ve-dima/FlightController_v2.0/doc/RC/RC.md

# Настройка пульта

Данный раздел описывает минимально необходимые действия, которые необходимы для подключения пульта к *Fly MCU 2.0*.

**ВЫПОЛНЯТЬ С СТРОГО ОТКЛЮЧЕННЫМИ ESC ОТ ПЛАТЫ ИЛИ СО СНЯТЫМИ ВИНТАМИ**

## Шаг 0. Подключение приёмника

Установите приёмник на любое удобное место в БПЛА. Закрепите также и антенны так, что бы они не попали в винты.

Затем возьмите 3 провода мама-мама и подключите их в разъём ***iBus servos*** (верхний правый угол).

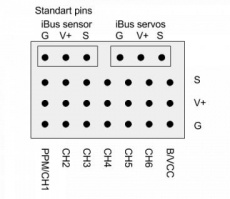
[picture p5: doc/RC/pinout.png]


Подключение к *Fly MCU 2.0* выполняется по следующей схеме:
| FS-iA6B, *iBus servos* | Fly MCU 2.0, *RC UART*, на плате LPUART1 |
| --- | --- |
| G | GND |
| V+ | +5V |
| S | RX |

Если, как минимум, **GND** и **+5V** были подключены правильно, при подключении питания загорится индикатор на приёмнике, сигнализирующий о наличии питания.

## Шаг 1. Привязка приёмника к передатчику

Затем необходимо обесточить БПЛА. Воткните bind-кабель (при отсутствии можно обычным кабелем мама-мама) в крайний правый разъём **B/VCC** приёмника.

(!) Предыдущее подключение остаётся на месте, шаги 2 и 4 с изображения не актуальны.

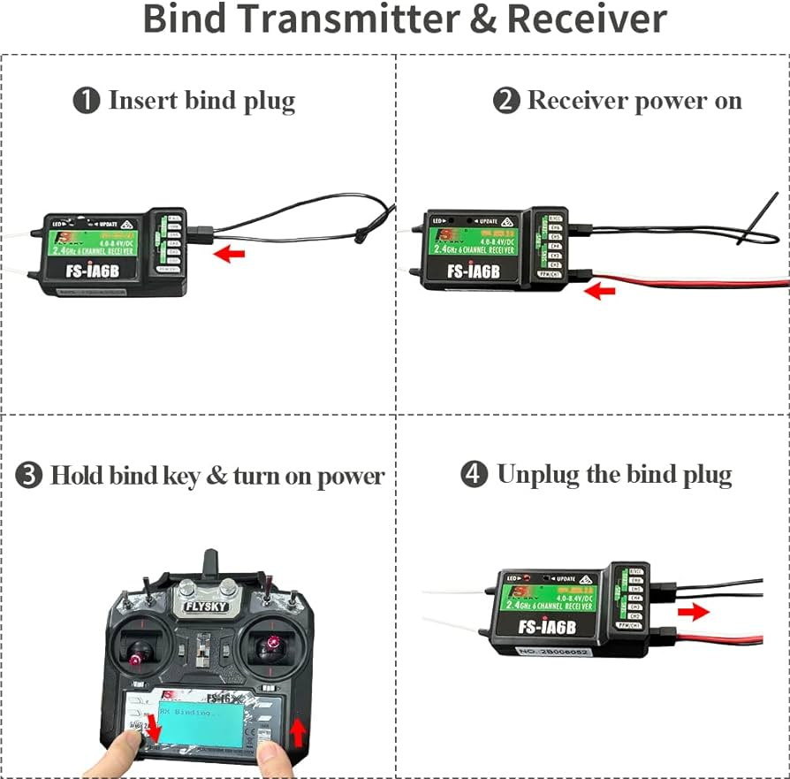
[picture p6: doc/RC/bind.jpg]


Убедитесь, что отключен и БПЛА, и пульт. Затем зажав **bind-key** включите передатчик. Вы должны увидеть надпись *RX Binding...*.

Затем включите БПЛА. Если все шаги были выполнены успешно, вы увидите экран с качеством сигнала и напряжением.

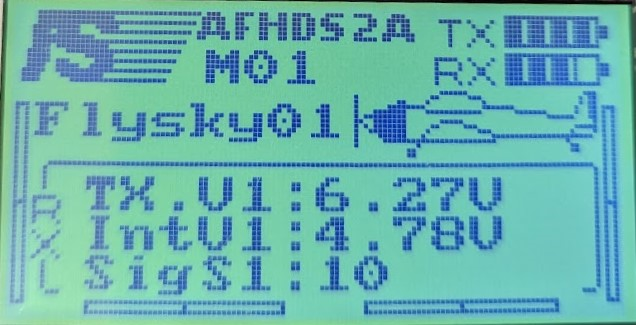
[picture p7: doc/RC/hello.jpg]


## Шаг 2. Настройка выхода

Удержанием кнопки **OK** (правее дисплея) зайдите в системное меню и кнопками **UP/DOWN** (левее дисплея) выберете пункт **System setup**.

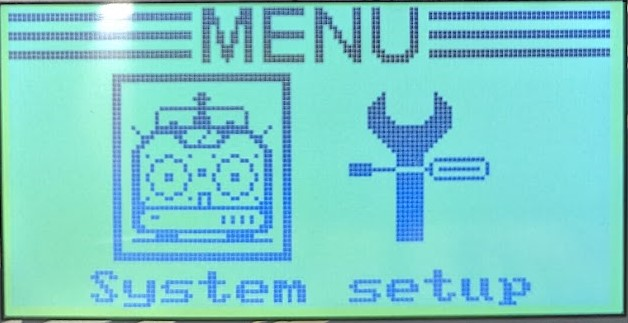
[picture p8: doc/RC/menu.jpg]


Найдите пункт **RX Setup**...

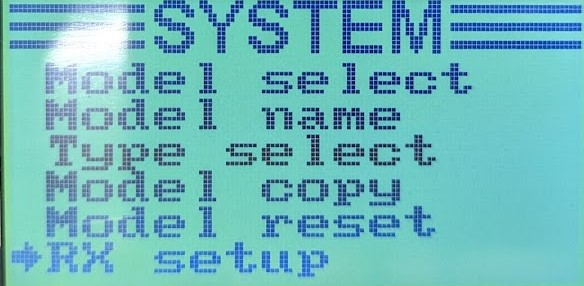
[picture p9: doc/RC/rx setup.jpg]


затем **Output mode**...

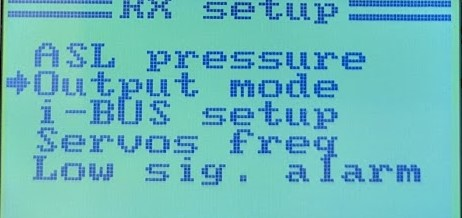
[picture p10: doc/RC/output mode.jpg]


Затем в Serial необходимо выбрать **S.BUS**.

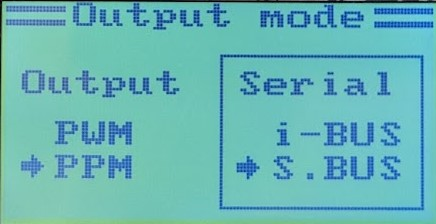
[picture p11: doc/RC/sbus.jpg]


Выход с сохранением - долгое удержание **CANCEL**!!! Лучше потом еще раз зайти в ту менюшку и проверить верность выставленных параметров.

## Шаг 3. Включение всех каналов

Удержанием кнопки **OK** (правее дисплея) зайдите в системное меню и кнопками **UP/DOWN** (левее дисплея) выберете пункт **System setup**.



Найдите пункт **Aux switches**...

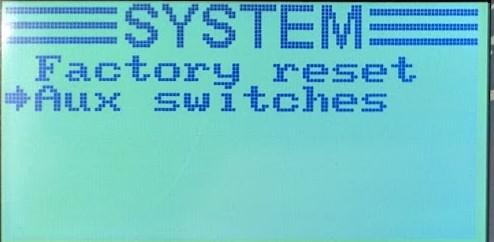
[picture p12: doc/RC/auxC.jpg]


и выставите следующие настройки:

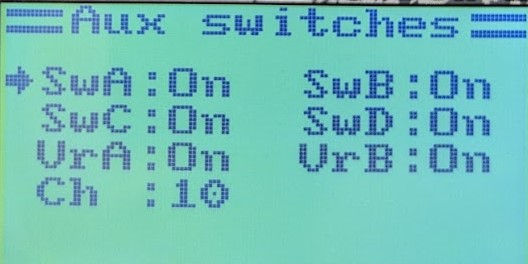
[picture p13: doc/RC/aux set.jpg]


Выход с сохранением - долгое удержание **CANCEL**!!! Лучше потом еще раз зайти в ту менюшку и проверить верность выставленных параметров.

## Шаг 4. Включение всех каналов

Удержанием кнопки **OK** (правее дисплея) зайдите в системное меню и кнопками **UP/DOWN** (левее дисплея) выберете пункт **Functions setup**.

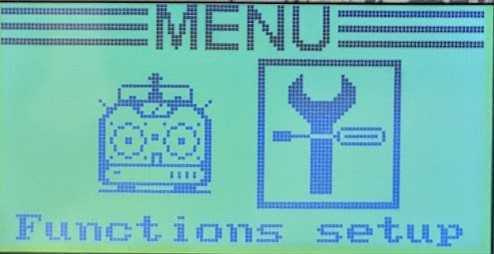
[picture p14: doc/RC/func.jpg]


Найдите пункт **Aux. channels**...

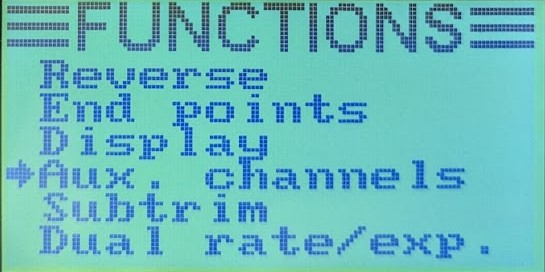
[picture p15: doc/RC/aux ch.jpg]


и установите соответствия между каналами и органами управления

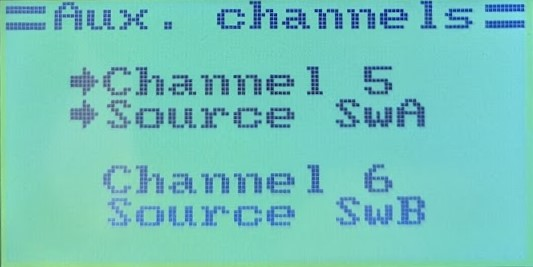
[picture p16: doc/RC/aux1.jpg]

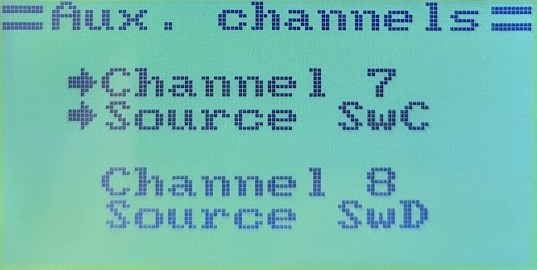
[picture p17: doc/RC/aux2.jpg]

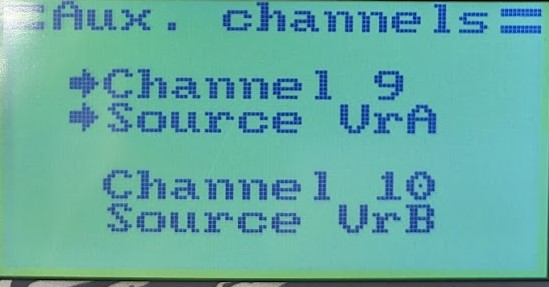
[picture p18: doc/RC/aux3.jpg]


Выход с сохранением - долгое удержание **CANCEL**!!! Лучше потом еще раз зайти в ту менюшку и проверить верность выставленных параметров.

# The end

После выполнения этих пунктов у Вас появится возможность управлять БПЛА а также использовать этот пульт для своих целей - Вам будет доступно сообщение **RC_CHANNELS_RAW (35)** из протокола **MavLink**, где вы можете получить позицию стиков/тумблеров/потенциометров.
