ve-dima/FlightController_v2.0/doc/IMU-module sch.pdf

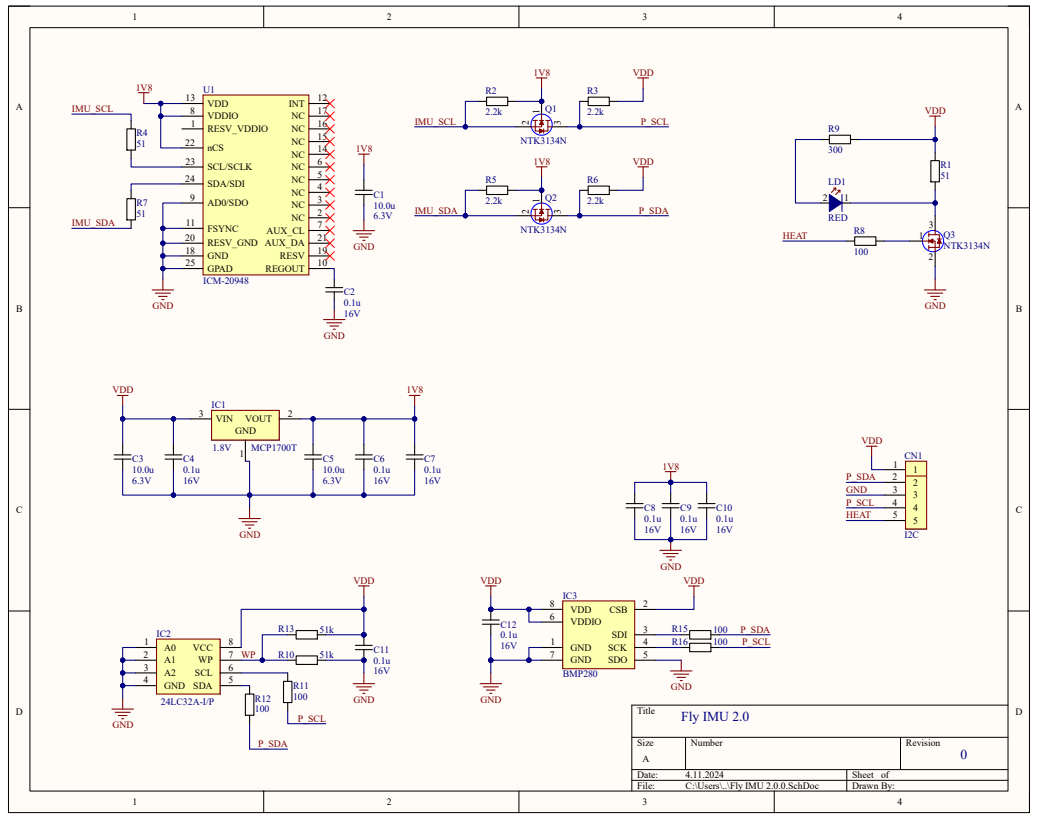
[picture p19: page 1]

Size A | Number | Revision 0

Date: 4.11.2024 | Sheet of
File: C:\Users\..\Fly IMU 2.0.0.SchDoc | Drawn By:
