ve-dima/FlightController_v2.0/doc/MCU sch.pdf

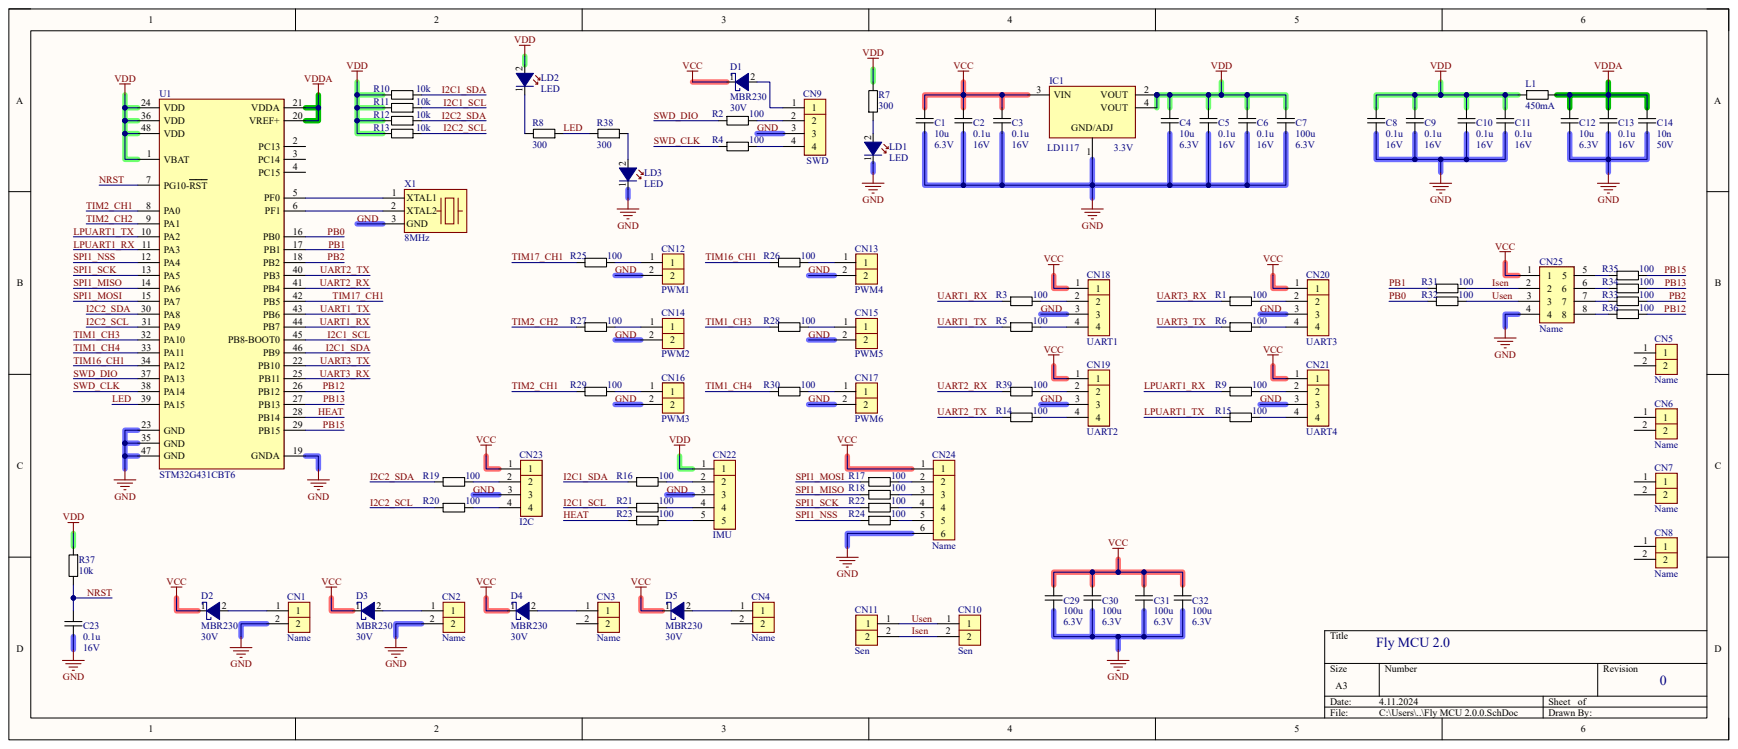
[picture p20: page 1]

VDD

Date: 4.11.2024 | Sheet of
File: C:\Users\..\Fly MCU 2.0.0.SchDoc | Drawn By:
