ve-dima/FlightController_v2.0/doc/PDB sch.pdf

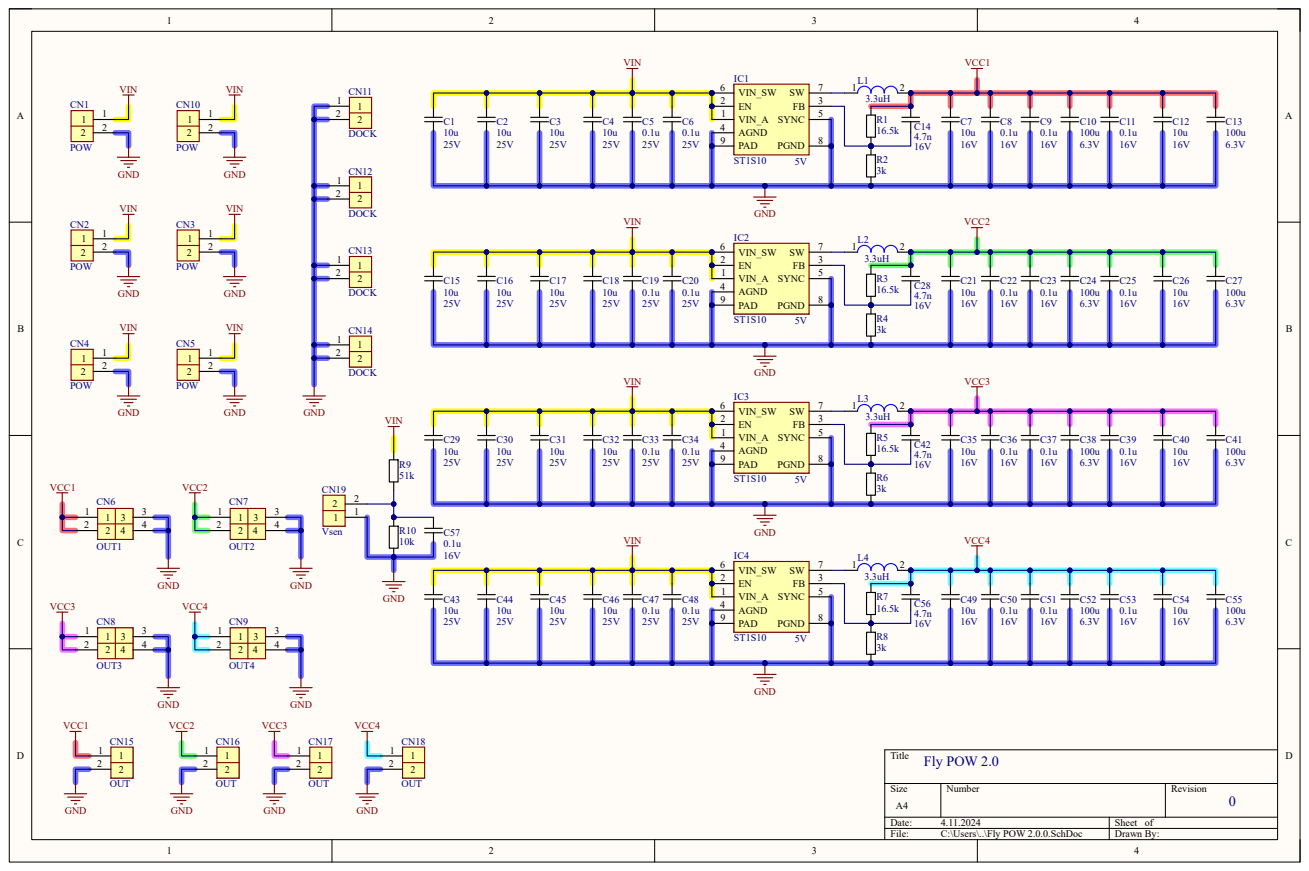
[picture p21: page 1]

Size A4 | Number | Revision 0

Date: 4.11.2024 | Sheet of
File: C:\Users\..\Fly POW 2.0.0.SchDoc | Drawn By:
