ve-dima/FlightController_v2.0/Cube32/FlightController_v2.0.ioc

Mcu.UserName=STM32G431CBTx
PA0.GPIO_Label=PWM4
PA0.Signal=S_TIM2_CH1
PA1.GPIO_Label=PWM1
PA1.Signal=S_TIM2_CH2
PA10.GPIO_Label=PWM3
PA10.Signal=S_TIM1_CH3
PA11.GPIO_Label=PWM2
PA11.Signal=S_TIM1_CH4
PA12.GPIO_Label=PWM5
PA12.Signal=S_TIM16_CH1
PA13.GPIO_Label=SWDIO
PA13.Signal=SYS_JTMS-SWDIO
PA14.GPIO_Label=SWCLK
PA14.Signal=SYS_JTCK-SWCLK
PA15.GPIO_Label=LED
PA15.Signal=GPIO_Output
PA2.GPIO_Label=RC_TX
PA2.Signal=LPUART1_TX
PA3.GPIO_Label=RC_RX
PA3.Signal=LPUART1_RX
PA4.GPIO_Label=NSS
PA4.Signal=SPI1_NSS
PA5.GPIO_Label=SCK
PA5.Signal=SPI1_SCK
PA6.GPIO_Label=MISO
PA6.Signal=SPI1_MISO
PA7.GPIO_Label=MOSI
PA7.Signal=SPI1_MOSI
PA8.GPIO_Label=SDA
PA8.Signal=I2C2_SDA
PA9.GPIO_Label=SCL
PA9.Signal=I2C2_SCL
PB0.GPIO_Label=V_Sens
PB0.Signal=ADC1_IN15
PB1.GPIO_Label=I_Sens
PB1.Signal=ADC1_IN12
PB10.GPIO_Label=Debug_TX
PB10.Signal=USART3_TX
PB11.GPIO_Label=Debug_RX
PB11.Signal=USART3_RX
PB12.GPIO_Label=IO4
PB12.Signal=GPIO_Input
PB13.GPIO_Label=IO2
PB13.Signal=GPIO_Input
PB14.GPIO_Label=IMU_HEAT
PB14.Signal=GPIO_Output
PB15.GPIO_Label=IO1
PB15.Signal=GPIO_Input
PB2.GPIO_Label=IO3
PB2.Signal=GPIO_Input
PB3.GPIO_Label=MAVLink1_TX
PB3.Signal=USART2_TX
PB4.GPIO_Label=MAVLink1_RX
PB4.Signal=USART2_RX
PB5.GPIO_Label=PWM6
PB5.Signal=S_TIM17_CH1
PB6.GPIO_Label=MAVLink0_TX
PB6.Signal=USART1_TX
PB7.GPIO_Label=MAVLink0_RX
PB7.Signal=USART1_RX
PB8-BOOT0.GPIO_Label=IMU_SCL
PB8-BOOT0.Signal=I2C1_SCL
PB9.GPIO_Label=IMU_SDA
PB9.Signal=I2C1_SDA
PC13.GPIO_Label=IMU_POWER
PC13.Signal=GPIO_Output
PF0-OSC_IN.Signal=RCC_OSC_IN
PF1-OSC_OUT.Signal=RCC_OSC_OUT
