ve-dima/FlightController_v2.0/src/motor/motor.hpp

#pragma once
#include <cstdint>

namespace Motor
{
    static constexpr unsigned maxCount = 4;

    static constexpr uint32_t disarmTime = 3'000;
    static constexpr uint32_t armTime = 10;

    enum class State
    {
        undefined,
        disarming,
        disarmed,
        arming,
        armed,
    };

    bool setPower(unsigned motor, float power);
    float getPower(unsigned motor);
    const float *const getPower();

    void disarm();
    void arm();
    State getState();

    void stateHandler();

    void updateOutput(unsigned motor);
}
