ve-dima/FlightController_v2.0/src/control/Control.hpp

#pragma once
#include <array>
#include <PID.hpp>
#include <Eigen/Geometry>

namespace Control
{
    union PIDSettings
    {
        struct
        {
            PIDf::Settings roll;
            PIDf::Settings pitch;
            PIDf::Settings yaw;
        } axis;
        std::array<PIDf::Settings, 3> settings;
    } extern rateSettings, angleSettings;
    extern PIDf::Settings velocitySetings, positionSettings;

    enum class TrustMode
    {
        MANUAL,
        VELOCITY,
        ALTITUDE,
    };
    inline TrustMode trustMode = TrustMode::MANUAL;

    extern float minimalTrust;
    extern float yawWeight;

    extern float targetAltitude;
    extern float targetVelocity;
    extern float autoHeightTrust;

    void rateHandler();
    void rotateVelocityHandler();
    void linearVelocityHandler();
    void positionControlHandler();
    void updateMotorPower();

    Eigen::Vector3f getTargetRate();
    Eigen::Quaternionf getTargetAttitude();
    float getTargetThrust();
    Eigen::Vector3f getTargetThrustVector();

    void setTargetRate(Eigen::Vector3f);
    void setTargetAttitude(Eigen::Quaternionf);
    void setTargetThrust(float);
}
