ve-dima/FlightController_v2.0/platform/stm32/ICM-20948/ICM-20948.cpp

#include "Common.hpp"
#include "Board.hpp"
#include "InvenSense_ICM20948_registers.hpp"
#include "AKM_AK09916_registers.hpp"
#include "ICM-20948.hpp"
#include "ahrs/ahrs.hpp"

using namespace InvenSense_ICM20948;

namespace ICM20948
{
    I2C &i2cBus = imuI2C;
    static constexpr uint8_t address = 0x68;

    uint8_t lastUsedBank = 0;
    void SelectRegisterBank(enum REG_BANK_SEL_BIT bank, bool force = false)
    {
        if (bank != lastUsedBank or force)
        {
            i2cBus.begin();
            i2cBus.startTx(address, 2);
            i2cBus.write(static_cast<uint8_t>(Register::BANK_0::REG_BANK_SEL));
            i2cBus.write(bank);
            i2cBus.waitStop();
            i2cBus.end();

            lastUsedBank = bank;
        }
    }

    void SelectRegisterBank(Register::BANK_0 reg) { SelectRegisterBank(REG_BANK_SEL_BIT::USER_BANK_0); }
    void SelectRegisterBank(Register::BANK_2 reg) { SelectRegisterBank(REG_BANK_SEL_BIT::USER_BANK_2); }
    void SelectRegisterBank(Register::BANK_3 reg) { SelectRegisterBank(REG_BANK_SEL_BIT::USER_BANK_3); }

    template <typename T>
    uint8_t RegisterRead(T reg)
    {
        uint8_t value;
        SelectRegisterBank(reg);

        i2cBus.begin();
        i2cBus.startTx(address, 1, false);
        i2cBus.write(static_cast<uint8_t>(reg));
        i2cBus.waitTransferComplete();
        i2cBus.startRx(address, 1);
        value = i2cBus.read();
        i2cBus.stop();
        i2cBus.end();

        return value;
    }

    template <typename T>
    void RegisterWrite(T reg, uint8_t value)
    {
        SelectRegisterBank(reg);

        i2cBus.begin();
        i2cBus.startTx(address, 2);
        i2cBus.write(static_cast<uint8_t>(reg));
        i2cBus.write(value);
        i2cBus.waitStop();
        i2cBus.end();
    }

    template <typename T>
    void RegisterSetAndClearBits(T reg, uint8_t setbits, uint8_t clearbits)
    {
        const uint8_t orig_val = RegisterRead(reg);

        uint8_t val = (orig_val & ~clearbits) | setbits;

        if (orig_val != val)
            RegisterWrite(reg, val);
    }

    template <typename T>
    bool RegisterCheck(const T &reg_cfg)
    {
        bool success = true;

        const uint8_t reg_value = RegisterRead(reg_cfg.reg);

        if (reg_cfg.set_bits && ((reg_value & reg_cfg.set_bits) != reg_cfg.set_bits))
            success = false;

        if (reg_cfg.clear_bits && ((reg_value & reg_cfg.clear_bits) != 0))
            success = false;

        return success;
    }

    void I2CSlaveRegisterWrite(uint8_t slave_i2c_addr, uint8_t reg, uint8_t val)
    {
        RegisterWrite(Register::BANK_3::I2C_SLV0_ADDR, slave_i2c_addr);
        RegisterWrite(Register::BANK_3::I2C_SLV0_REG, reg);
        RegisterWrite(Register::BANK_3::I2C_SLV0_DO, val);
    }

    void I2CSlaveExternalSensorDataEnable(uint8_t slave_i2c_addr, uint8_t reg, uint8_t size)
    {
        RegisterWrite(Register::BANK_3::I2C_SLV0_ADDR, slave_i2c_addr | I2C_SLV0_ADDR_BIT::I2C_SLV0_RNW);
        RegisterWrite(Register::BANK_3::I2C_SLV0_REG, reg);
        RegisterWrite(Register::BANK_3::I2C_SLV0_CTRL, size | I2C_SLV0_CTRL_BIT::I2C_SLV0_EN);
    }

    void I2CSlaveExternalSensorDataRead(uint8_t *buffer, uint8_t length)
    {
        SelectRegisterBank(REG_BANK_SEL_BIT::USER_BANK_0);

        i2cBus.begin();
        i2cBus.startTx(address, 1, false);
        i2cBus.write(static_cast<uint8_t>(Register::BANK_0::EXT_SLV_SENS_DATA_00) | DIR_READ);
        i2cBus.waitTransferComplete();
        i2cBus.startRx(address, length);
        for (uint8_t i = 0; i < length; i++)
            buffer[i] = i2cBus.read();
        i2cBus.stop();
        i2cBus.end();
    }

    struct register_bank0_config_t
    {
        Register::BANK_0 reg;
        uint8_t set_bits{0};
        uint8_t clear_bits{0};
    };

    struct register_bank2_config_t
    {
        Register::BANK_2 reg;
        uint8_t set_bits{0};
        uint8_t clear_bits{0};
    };

    struct register_bank3_config_t
    {
        Register::BANK_3 reg;
        uint8_t set_bits{0};
        uint8_t clear_bits{0};
    };

    static constexpr register_bank0_config_t _register_bank0_cfg[] = {
        // Register                             | Set bits, Clear bits
        {Register::BANK_0::USER_CTRL, USER_CTRL_BIT::I2C_MST_EN, USER_CTRL_BIT::DMP_EN | USER_CTRL_BIT::I2C_IF_DIS | USER_CTRL_BIT::I2C_MST_RST},
        {Register::BANK_0::PWR_MGMT_1, 0, PWR_MGMT_1_BIT::DEVICE_RESET | PWR_MGMT_1_BIT::SLEEP | PWR_MGMT_1_BIT::TEMP_DIS},
        {Register::BANK_0::INT_PIN_CFG, 0, INT_PIN_CFG_BIT::BYPASS_EN},
    };

    static constexpr register_bank2_config_t _register_bank2_cfg[] = {
        // Register                             | Set bits, Clear bits
        {Register::BANK_2::GYRO_SMPLRT_DIV, 0, 0},
        {Register::BANK_2::ACCEL_SMPLRT_DIV_2, 0, 0},
        {Register::BANK_2::GYRO_CONFIG_1, GYRO_CONFIG_1_BIT::GYRO_FS_SEL_2000_DPS | GYRO_CONFIG_1_BIT::GYRO_DLPFCFG_36 | GYRO_CONFIG_1_BIT::GYRO_FCHOICE},
        {Register::BANK_2::ACCEL_CONFIG, ACCEL_CONFIG_BIT::ACCEL_FS_SEL_16G | ACCEL_CONFIG_BIT::ACCEL_DLPFCFG_8 | ACCEL_CONFIG_BIT::ACCEL_FCHOICE},
    };

    static constexpr register_bank3_config_t _register_bank3_cfg[] = {
        // Register                             | Set bits, Clear bits
        {Register::BANK_3::I2C_MST_CTRL, I2C_MST_CTRL_BIT::I2C_MST_P_NSR | I2C_MST_CTRL_BIT::I2C_MST_CLK_400_kHz, 0},
        {Register::BANK_3::I2C_MST_DELAY_CTRL, I2C_MST_DELAY_CTRL_BIT::I2C_SLVX_DLY_EN, 0},
        {Register::BANK_3::I2C_SLV4_CTRL, I2C_SLV4_CTRL_BIT::I2C_MST_DLY, 0},
    };

    constexpr float GYROSCOPE_SENSOR_MAX = 2000;                  // dps
    constexpr float GYROSCOPE_SENSOR_MIN = -GYROSCOPE_SENSOR_MAX; // dps
    constexpr float GYROSCOPE_SENSITIVITY = (GYROSCOPE_SENSOR_MAX / (1 << 15)) *
                                            (M_PI / 180); // rad/LSB

    constexpr float ACCELEROMETER_SENSOR_MAX = 16;                                    // G
    constexpr float ACCELEROMETER_SENSOR_MIN = -ACCELEROMETER_SENSOR_MAX;             // G
    constexpr float ACCELEROMETER_SENSITIVITY = ACCELEROMETER_SENSOR_MAX / (1 << 15); // G/LSB

    enum class STATE : uint8_t
    {
        RESET,
        WAIT_FOR_RESET,
        CONFIGURE,
        MAG_RESET,
        MAG_WHOIM_REQ,
        MAG_WAIT_WHOIM,
        OK,
    } state{STATE::RESET};

    uint32_t magnetometerTimer = 0;

    void isr()
    {
        DATA_seq data{};

        i2cBus.begin();
        i2cBus.startTx(address, 1, false);
        i2cBus.write(static_cast<uint8_t>(Register::BANK_0::ACCEL_XOUT_H));
        i2cBus.waitTransferComplete();
        i2cBus.startRx(address, sizeof(data));
        for (uint8_t &byte : data.u8data)
            byte = i2cBus.read();
        i2cBus.stop();
        i2cBus.end();

        for (uint16_t &half : data.u816data)
            half = __REVSH(half);

        std::swap(data.vec.accel.x(), data.vec.accel.y());
        std::swap(data.vec.gyro.x(), data.vec.gyro.y());

        Eigen::Vector3f gyro = Eigen::Vector3f(data.vec.gyro.cast<float>()) * GYROSCOPE_SENSITIVITY,
                        accel = Eigen::Vector3f(data.vec.accel.cast<float>()) * ACCELEROMETER_SENSITIVITY;
        AHRS::updateByIMU(gyro, accel, 1 / 224.77);

        if (millis() - magnetometerTimer > (1000 / 50))
        {
            magnetometerTimer = millis();
            AKM_AK09916::TransferBuffer buffer{};
            I2CSlaveExternalSensorDataRead((uint8_t *)&buffer, sizeof(buffer));
            magIsRead = true;

            if (not(buffer.ST2 & AKM_AK09916::ST2_BIT::HOFL) and
                (buffer.ST1 & AKM_AK09916::ST1_BIT::DRDY))
            {
                Eigen::Vector3f mag{
                    -float(int16_t(buffer.HYL | (buffer.HYH << 8))),
                    float(int16_t(buffer.HXL | (buffer.HXH << 8))),
                    -float(int16_t(buffer.HZL | (buffer.HZH << 8))),
                };
                mag *= AKM_AK09916::MAGNETOMETER_SENSITIVITY;
                AHRS::updateByMagnetometer(mag);
            }
            // I2CSlaveExternalSensorDataEnable(AKM_AK09916::I2C_ADDRESS_DEFAULT, (uint8_t)AKM_AK09916::Register::ST1, sizeof(AKM_AK09916::TransferBuffer));
        }
    }

    void handler()
    {
        static uint32_t delayTime = 0, lastTime = 0;
        const uint32_t now = millis();

        if (millis() - lastTime < delayTime)
            return;
        lastTime = now;

        switch (state)
        {
        case STATE::RESET:
        {
            // PWR_MGMT_1: Device Reset
            SelectRegisterBank(REG_BANK_SEL_BIT::USER_BANK_0, true);
            RegisterWrite(Register::BANK_0::PWR_MGMT_1, PWR_MGMT_1_BIT::DEVICE_RESET);

            state = STATE::WAIT_FOR_RESET;
            delayTime = 100;
            break;
        }
        case STATE::WAIT_FOR_RESET:
        {
            SelectRegisterBank(REG_BANK_SEL_BIT::USER_BANK_0, true);
            uint8_t whoim = RegisterRead(Register::BANK_0::WHO_AM_I);

            // The reset value is 0x00 for all registers other than the registers below
            if ((whoim == WHOAMI) && (RegisterRead(Register::BANK_0::PWR_MGMT_1) == 0x41))
            {
                // Wakeup and reset
                RegisterSetAndClearBits(Register::BANK_0::PWR_MGMT_1, 0, PWR_MGMT_1_BIT::SLEEP);

                // if reset succeeded then configure
                state = STATE::CONFIGURE;
                delayTime = 1;
            }
            else
            {
                state = STATE::RESET;
                delayTime = 100;
            }

            break;
        }
        case STATE::CONFIGURE:
        {
            for (const auto &reg_cfg : _register_bank0_cfg)
                RegisterSetAndClearBits(reg_cfg.reg, reg_cfg.set_bits, reg_cfg.clear_bits);

            for (const auto &reg_cfg : _register_bank2_cfg)
                RegisterSetAndClearBits(reg_cfg.reg, reg_cfg.set_bits, reg_cfg.clear_bits);

            for (const auto &reg_cfg : _register_bank3_cfg)
                RegisterSetAndClearBits(reg_cfg.reg, reg_cfg.set_bits, reg_cfg.clear_bits);

            // now check that all are configured
            bool success = true;

            for (const auto &reg_cfg : _register_bank0_cfg)
                if (!RegisterCheck(reg_cfg))
                    success = false;

            for (const auto &reg_cfg : _register_bank2_cfg)
                if (!RegisterCheck(reg_cfg))
                    success = false;

            for (const auto &reg_cfg : _register_bank3_cfg)
                if (!RegisterCheck(reg_cfg))
                    success = false;

            if (success)
            {
                SelectRegisterBank(REG_BANK_SEL_BIT::USER_BANK_0, true);
                state = STATE::MAG_RESET;
                delayTime = 10;
            }
            else
            {
                state = STATE::RESET;
                delayTime = 10;
            }

            break;
        }
        case STATE::MAG_RESET:
        {
            // Magnetometer
            I2CSlaveRegisterWrite(AKM_AK09916::I2C_ADDRESS_DEFAULT, (uint8_t)AKM_AK09916::Register::CNTL3, AKM_AK09916::CNTL3_BIT::SRST);

            state = STATE::MAG_WHOIM_REQ;
            delayTime = 100;

            break;
        }
        case STATE::MAG_WHOIM_REQ:
        {
            // Get magnetometer whoim
            I2CSlaveExternalSensorDataEnable(AKM_AK09916::I2C_ADDRESS_DEFAULT, (uint8_t)AKM_AK09916::Register::WIA1, 1);

            state = STATE::MAG_WAIT_WHOIM;
            delayTime = 100;

            break;
        }
        case STATE::MAG_WAIT_WHOIM:
        {
            uint8_t WIA1 = 0;
            I2CSlaveExternalSensorDataRead(&WIA1, 1);

            if (WIA1 == AKM_AK09916::Company_ID)
            {
                I2CSlaveRegisterWrite(AKM_AK09916::I2C_ADDRESS_DEFAULT, (uint8_t)AKM_AK09916::Register::CNTL2, AKM_AK09916::CNTL2_BIT::MODE3);
                delay(5);
                // I2CSlaveExternalSensorDataEnable(AKM_AK09916::I2C_ADDRESS_DEFAULT, (uint8_t)AKM_AK09916::Register::ST1, sizeof(AKM_AK09916::TransferBuffer));
                state = STATE::OK;
                delayTime = 10;
                magnetometerTimer = millis();
            }
            else
                state = STATE::MAG_RESET;

            break;
        }
        default:
            delayTime = 0;
            isr();
            break;
        }
    }

    bool isOK() { return state == STATE::OK; }
}
