ve-dima/FlightController_v2.0/platform/stm32/ICM-20948/InvenSense_ICM20948_registers.hpp

#pragma once

#include <cstdint>
#include <cstddef>
#include <Eigen/Core>

namespace InvenSense_ICM20948
{
	// TODO: move to a central header
	static constexpr uint8_t Bit0 = (1 << 0);
	static constexpr uint8_t Bit1 = (1 << 1);
	static constexpr uint8_t Bit2 = (1 << 2);
	static constexpr uint8_t Bit3 = (1 << 3);
	static constexpr uint8_t Bit4 = (1 << 4);
	static constexpr uint8_t Bit5 = (1 << 5);
	static constexpr uint8_t Bit6 = (1 << 6);
	static constexpr uint8_t Bit7 = (1 << 7);

	static constexpr uint8_t DIR_READ = 0x80;

	static constexpr uint8_t WHOAMI = 0xEA;

	static constexpr float TEMPERATURE_SENSITIVITY = 333.87f; // LSB/C
	static constexpr float TEMPERATURE_OFFSET = 21.f;		  // C
	static constexpr float TEMPERATURE_SENSOR_MIN = -40.f;	  // °C
	static constexpr float TEMPERATURE_SENSOR_MAX = 85.f;	  // °C

	namespace Register
	{

		enum class BANK_0 : uint8_t
		{
			WHO_AM_I = 0x00,

			USER_CTRL = 0x03,

			PWR_MGMT_1 = 0x06,

			INT_PIN_CFG = 0x0F,

			INT_ENABLE_1 = 0x11,

			I2C_MST_STATUS = 0x17,

			ACCEL_XOUT_H = 0x2D,

			TEMP_OUT_H = 0x39,
			TEMP_OUT_L = 0x3A,
			EXT_SLV_SENS_DATA_00 = 0x3B,
			// [EXT_SLV_SENS_DATA_01, EXT_SLV_SENS_DATA_22]
			EXT_SLV_SENS_DATA_23 = 0x52,

			FIFO_EN_2 = 0x67,
			FIFO_RST = 0x68,
			FIFO_MODE = 0x69,
			FIFO_COUNTH = 0x70,
			FIFO_COUNTL = 0x71,
			FIFO_R_W = 0x72,

			FIFO_CFG = 0x76,

			REG_BANK_SEL = 0x7F,
		};

		enum class BANK_2 : uint8_t
		{
			GYRO_SMPLRT_DIV = 0x00,
			GYRO_CONFIG_1 = 0x01,
			GYRO_CONFIG_2 = 0x02,

			ACCEL_SMPLRT_DIV_2 = 0x11,

			ACCEL_CONFIG = 0x14,

			REG_BANK_SEL = 0x7F,
		};

		enum class BANK_3 : uint8_t
		{
			I2C_MST_CTRL = 0x01,
			I2C_MST_DELAY_CTRL = 0x02,

			I2C_SLV0_ADDR = 0x03,
			I2C_SLV0_REG = 0x04,
			I2C_SLV0_CTRL = 0x05,
			I2C_SLV0_DO = 0x06,

			I2C_SLV4_CTRL = 0x15,

			REG_BANK_SEL = 0x7F,
		};

	};

	//---------------- BANK0 Register bits
	// USER_CTRL
	enum USER_CTRL_BIT : uint8_t
	{
		DMP_EN = Bit7,
		FIFO_EN = Bit6,
		I2C_MST_EN = Bit5,	// Enable the I2C Master I/F module
		I2C_IF_DIS = Bit4,	// Reset I2C Slave module and put the serial interface in SPI mode only
		DMP_RST = Bit3,		// Reset DMP module. Reset is asynchronous. This bit auto clears after one clock cycle of the internal 20 MHz clock.
		SRAM_RST = Bit2,	// Reset SRAM module. Reset is asynchronous. This bit auto clears after one clock cycle of the internal 20 MHz clock.
		I2C_MST_RST = Bit1, // Reset I2C Master module.
	};

	// PWR_MGMT_1
	enum PWR_MGMT_1_BIT : uint8_t
	{
		DEVICE_RESET = Bit7,
		SLEEP = Bit6,

		TEMP_DIS = Bit3,
		CLKSEL_2 = Bit2,
		CLKSEL_1 = Bit1,
		CLKSEL_0 = Bit0,
	};

	// INT_PIN_CFG
	enum INT_PIN_CFG_BIT : uint8_t
	{
		INT1_ACTL = Bit7,
		BYPASS_EN = Bit1, // When asserted, the I2C_MASTER interface pins (ES_CL and ES_DA) will go into ‘bypass mode’ when the I 2 C master interface is disabled.
	};

	// INT_ENABLE_1
	enum INT_ENABLE_1_BIT : uint8_t
	{
		RAW_DATA_0_RDY_EN = Bit0,
	};

	// FIFO_EN_2
	enum FIFO_EN_2_BIT : uint8_t
	{
		ACCEL_FIFO_EN = Bit4,
		GYRO_Z_FIFO_EN = Bit3,
		GYRO_Y_FIFO_EN = Bit2,
		GYRO_X_FIFO_EN = Bit1,
		TEMP_FIFO_EN = Bit0,
	};

	// FIFO_RST
	enum FIFO_RST_BIT : uint8_t
	{
		FIFO_RESET = Bit4 | Bit3 | Bit2 | Bit1 | Bit0,
	};

	// FIFO_MODE
	enum FIFO_MODE_BIT : uint8_t
	{
		Snapshot = Bit0,
	};

	// FIFO_CFG
	enum FIFO_CFG_BIT : uint8_t
	{
		FIFO_CFG = Bit0,
	};

	// REG_BANK_SEL
	enum REG_BANK_SEL_BIT : uint8_t
	{
		USER_BANK_0 = 0,		   // 0: Select USER BANK 0.
		USER_BANK_1 = Bit4,		   // 1: Select USER BANK 1.
		USER_BANK_2 = Bit5,		   // 2: Select USER BANK 2.
		USER_BANK_3 = Bit5 | Bit4, // 3: Select USER BANK 3.
	};

	//---------------- BANK2 Register bits
	// GYRO_CONFIG_1
	enum GYRO_CONFIG_1_BIT : uint8_t
	{
		// 5:3 GYRO_DLPFCFG[2:0]
		GYRO_DLPFCFG = Bit5 | Bit4 | Bit3, // 7 -

		GYRO_DLPFCFG_197 = 0 << 3,
		GYRO_DLPFCFG_120 = 2 << 3,
		GYRO_DLPFCFG_36 = 4 << 3,
		GYRO_DLPFCFG_8 = 6 << 3,

		// 2:1 GYRO_FS_SEL[1:0]
		GYRO_FS_SEL_250_DPS = 0,			// 0b00 = ±250 dps
		GYRO_FS_SEL_500_DPS = Bit1,			// 0b01 = ±500 dps
		GYRO_FS_SEL_1000_DPS = Bit2,		// 0b10 = ±1000 dps
		GYRO_FS_SEL_2000_DPS = Bit2 | Bit1, // 0b11 = ±2000 dps

		GYRO_FCHOICE = Bit0, // 0 – Bypass gyro DLPF
	};

	// GYRO_CONFIG_2
	enum GYRO_CONFIG_2_BIT : uint8_t
	{
		XGYRO_CTEN = Bit5,
		YGYRO_CTEN = Bit4,
		ZGYRO_CTEN = Bit3,
	};

	// ACCEL_CONFIG
	enum ACCEL_CONFIG_BIT : uint8_t
	{
		// 5:3 ACCEL_DLPFCFG[2:0]
		ACCEL_DLPFCFG = Bit5 | Bit4 | Bit3, // 7 -

		ACCEL_DLPFCFG_246 = 0 << 3,
		ACCEL_DLPFCFG_111 = 2 << 3,
		ACCEL_DLPFCFG_34 = 4 << 3,
		ACCEL_DLPFCFG_8 = 6 << 3,

		// 2:1 ACCEL_FS_SEL[1:0]
		ACCEL_FS_SEL_2G = 0,			// 0b00: ±2g
		ACCEL_FS_SEL_4G = Bit1,			// 0b01: ±4g
		ACCEL_FS_SEL_8G = Bit2,			// 0b10: ±8g
		ACCEL_FS_SEL_16G = Bit2 | Bit1, // 0b11: ±16g

		ACCEL_FCHOICE = Bit0, // 0: Bypass accel DLPF
	};

	//---------------- BANK3 Register bits

	// I2C_MST_CTRL
	enum I2C_MST_CTRL_BIT : uint8_t
	{
		I2C_MST_P_NSR = Bit4, // I2C Master’s transition from one slave read to the next slave read

		// I2C_MST_CLK [3:0]
		I2C_MST_CLK_400_kHz = 7, // To achieve a targeted clock frequency of 400 kHz, MAX, it is recommended to set I2C_MST_CLK = 7 (345.6 kHz / 46.67% duty cycle)
	};

	// I2C_MST_DELAY_CTRL
	enum I2C_MST_DELAY_CTRL_BIT : uint8_t
	{
		I2C_SLVX_DLY_EN = Bit4 | Bit3 | Bit2 | Bit1 | Bit0, // limit all slave access (1+I2C_MST_DLY)
	};

	// I2C_SLV0_ADDR
	enum I2C_SLV0_ADDR_BIT : uint8_t
	{
		I2C_SLV0_RNW = Bit7, // 1 – Transfer is a read

		// I2C_ID_0[6:0]
		I2C_ID_0 = Bit6 | Bit5 | Bit4 | Bit3 | Bit2 | Bit1 | Bit0, // Physical address of I2C slave 0
	};

	// I2C_SLV0_CTRL
	enum I2C_SLV0_CTRL_BIT : uint8_t
	{
		I2C_SLV0_EN = Bit7,		 // Enable reading data from this slave
		I2C_SLV0_BYTE_SW = Bit6, // Swap bytes when reading both the low and high byte of a word
		I2C_SLV0_REG_DIS = Bit5, // transaction does not write a register value (only read data)

		I2C_SLV0_LENG = Bit3 | Bit2 | Bit1 | Bit0, // Number of bytes to be read from I2C slave 0
	};

	// I2C_SLV4_CTRL
	enum I2C_SLV4_CTRL_BIT : uint8_t
	{
		// I2C_MST_DLY[4:0]
		I2C_MST_DLY = Bit4 | Bit3 | Bit2 | Bit1 | Bit0,
	};

	union DATA_seq
	{
		struct vec_t
		{
			Eigen::Vector3<int16_t> accel, gyro;
		} vec;

		struct
		{
			uint8_t ACCEL_XOUT_H;
			uint8_t ACCEL_XOUT_L;
			uint8_t ACCEL_YOUT_H;
			uint8_t ACCEL_YOUT_L;
			uint8_t ACCEL_ZOUT_H;
			uint8_t ACCEL_ZOUT_L;
			uint8_t GYRO_XOUT_H;
			uint8_t GYRO_XOUT_L;
			uint8_t GYRO_YOUT_H;
			uint8_t GYRO_YOUT_L;
			uint8_t GYRO_ZOUT_H;
			uint8_t GYRO_ZOUT_L;
		};

		uint8_t u8data[12];
		uint16_t u816data[6];
	};

}
