ve-dima/FlightController_v2.0/platform/stm32/ICM-20948/AKM_AK09916_registers.hpp

/****************************************************************************
 *
 *   Copyright (c) 2019-2020 PX4 Development Team. All rights reserved.
 *
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
 * 1. Redistributions of source code must retain the above copyright
 *    notice, this list of conditions and the following disclaimer.
 * 2. Redistributions in binary form must reproduce the above copyright
 *    notice, this list of conditions and the following disclaimer in
 *    the documentation and/or other materials provided with the
 *    distribution.
 * 3. Neither the name PX4 nor the names of its contributors may be
 *    used to endorse or promote products derived from this software
 *    without specific prior written permission.
 *
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
 ****************************************************************************/

/**
 * @file AKM_AK09916_registers.hpp
 *
 * Asahi Kasei Microdevices (AKM) AK09916 registers.
 *
 */

#pragma once
#include <cstdint>
#include <Eigen/Core>

namespace AKM_AK09916
{

	// TODO: move to a central header
	static constexpr uint8_t Bit0 = (1 << 0);
	static constexpr uint8_t Bit1 = (1 << 1);
	static constexpr uint8_t Bit2 = (1 << 2);
	static constexpr uint8_t Bit3 = (1 << 3);
	static constexpr uint8_t Bit4 = (1 << 4);
	static constexpr uint8_t Bit5 = (1 << 5);
	static constexpr uint8_t Bit6 = (1 << 6);
	static constexpr uint8_t Bit7 = (1 << 7);

	static constexpr uint8_t I2C_ADDRESS_DEFAULT = 0b0001100;

	static constexpr uint8_t Company_ID = 0x48;
	static constexpr uint8_t Device_ID = 0x09;

	constexpr float MAGNETOMETER_SENSOR_MAX = 4900;						// uT
	constexpr float MAGNETOMETER_SENSOR_MIN = -MAGNETOMETER_SENSOR_MAX; // uT
	constexpr float MAGNETOMETER_SENSITIVITY = 0.15;					// uT/LSB

	enum class Register : uint8_t
	{
		WIA1 = 0x00, // Company ID of AKM
		WIA2 = 0x01, // Device ID of AK09916

		ST1 = 0x10, // Status 1
		HXL = 0x11,
		HXH = 0x12,
		HYL = 0x13,
		HYH = 0x14,
		HZL = 0x15,
		HZH = 0x16,

		ST2 = 0x18, // Status 2

		CNTL2 = 0x31, // Control 2
		CNTL3 = 0x32, // Control 3
	};

	// ST1
	enum ST1_BIT : uint8_t
	{
		DOR = Bit1,	 // Data overrun
		DRDY = Bit0, // Data is ready
	};

	// ST2
	enum ST2_BIT : uint8_t
	{
		HOFL = Bit3, // Magnetic sensor overflow
	};

	// CNTL2
	enum CNTL2_BIT : uint8_t
	{
		// MODE[4:0] bits
		MODE1 = Bit1,		 // “00010”: Continuous measurement mode 1 (10Hz)
		MODE2 = Bit2,		 // “00100”: Continuous measurement mode 2 (20Hz)
		MODE3 = Bit2 | Bit1, // “00110”: Continuous measurement mode 3 (50Hz)
		MODE4 = Bit3,		 // “01000”: Continuous measurement mode 4 (100Hz)
	};

	// CNTL3
	enum CNTL3_BIT : uint8_t
	{
		SRST = Bit0,
	};

	struct TransferBuffer
	{
		
		uint8_t ST1;
		uint8_t HXL;
		uint8_t HXH;
		uint8_t HYL;
		uint8_t HYH;
		uint8_t HZL;
		uint8_t HZH;
		uint8_t TMPS;
		uint8_t ST2;
	};

} // namespace AKM_AK09916
