ve-dima/FlightController_v2.0/platform/stm32/Board.hpp

#pragma once
#include "UART/Uart.hpp"
#include "I2C/I2C.hpp"

inline constexpr UART &rcUart = lpuart1;
inline constexpr UART &rcTelemUart = uart3;

inline constexpr UART &mav0Uart = uart1;
inline constexpr UART &mav1Uart = uart2;

inline constexpr I2C &imuI2C = i2c1;
inline constexpr I2C &i2c = i2c2;
