ve-dima/FlightController_v2.0/tools/parse_serial.py

#!/usr/bin/env python3
from operator import contains
from typing import Container
from crsf_parser import CRSFParser, PacketValidationStatus
from serial import Serial

from crsf_parser.payloads import PacketsTypes
from crsf_parser.handling import crsf_build_frame


def print_frame(frame: Container, status: PacketValidationStatus) -> None:
    print(
        f"""
    {status}
    {frame}
    """
    )


crsf_parser = CRSFParser(print_frame)
n = 10
v = 1
with Serial("COM12", 420_000, timeout=2) as ser:
    input = bytearray()
    while True:
        if n == 0:
            n = 10
            frame = crsf_build_frame(
                PacketsTypes.BATTERY_SENSOR,
                {"voltage": v, "current": 1, "capacity": 100, "remaining": 100},
            )
            v += 1
            ser.write(frame)
        n = n - 1
        values = ser.read(100)
        input.extend(values)
        crsf_parser.parse_stream(input)
