ve-dima/FlightController_v2.0/(commit log)

2024-04-15 Создал систему параметров с compile-time сортировкой по названию
2024-04-18 добавил mavlink, запустил IMU
2024-04-18 удалил сомнительную штуку
2024-04-18 Дописал работу ШИМ выходов
2024-04-18 Add PWM output
2024-04-19 набросок AHRS
2024-04-21 make fusion of gyroscope and accelerometer
2024-04-22 пультик
2024-04-24 LED driver
2024-04-29 UART on DMA, add CRSF, add flight modes switcher
2024-05-04 add yaw weight control
2024-05-06 add control of roll and pitch in stab mode
2024-05-07 add idle IRQ for uart, yaw and tilt set
2024-05-07 fix signs of trust mixer, make RC callback on IDLE IRQ
    [Control.cpp, RC.cpp, Uart.cpp, Uart.hpp, motor.cpp, motor.hpp, setup.cpp]
2024-05-15 классно пока летает
2024-05-21 add Kalman filter
2024-05-21 change process noise matrix, maybe work
    [Control.cpp, Control.hpp, imu.cpp]
2024-05-24 cool filter
2024-05-25 filter and stabilizer
2024-05-31 rcc, integral windup fix, add compass
    [AKM_AK09916_registers.hpp, Control.cpp, Control_param.cpp, FlightController_v2.0.ioc, ICM-20948.cpp, RC.cpp]
2024-06-05 speedup clock to 160 MHz on external oscillator, fix S-Bus, update CubeMX pinout, some other fix
    [BMP280.cpp, FlightController_v2.0.ioc, ICM-20948.cpp, LED.cpp, RC.cpp, S-Bus.cpp]
2024-06-06 some fix, add indicator
    [Control.cpp, Control_param.cpp, ICM-20948.cpp, LED.cpp, RC.cpp]
2024-06-19 fix yaw, make altitude stab
    [Control.cpp, Control_param.cpp, motor.cpp, motor.hpp]
2024-06-19 add servo-controller
2024-06-21 Channel change, fix bug with led, add tilt protection on ARM,
    [LED.cpp, RC.cpp]
2024-06-21 add I-Bus telemetry, add half-duplex function in UART library
2024-06-22 add ADC driver, percent calculation fot battery
2024-06-22 add voltage read with VRef and calibration data
2024-06-24 fix adc
